ElregS/PE-1100_Elreg_Sender/Documentation/TODO.txt

1. wrong OP AMP footprint (mirror)
2. DAC D7. Remove pin 28 and use PIN 60 as D7 (do same on the other channel?)
3. Capacitor after first opamp replacet with schotky. Try again with 1uF or change schematic as terje sugested
