ElregS/PE-1100_Elreg_Sender/Documents/Trafo/Haris_uktatko_Savjeti.odt

Mislim da toridualni ferit nije dobar zato sto ima malu Effective area (ispada da se ne racuna bas kao poprjecni prjesjek). Inace bi bio dobar jer ima malo rasipanja.

Ispada da moram naci minimalni broj namotaja. Onda namotam koliko mogu na sekundar (npr .primar 5, sekundar 50), Onda iz toga vidim koliki mogu imati napon na sekundaru.

Npr. ako je primar 60Vpp, onda na sekundaru mogu dobiti 600Vpp. To znaci da je struja na 6App ako je 100 Ohma. Na primaru moram obezbjediti 60App

Ako je transducer 200 Ohma, onda moram smanjiti struju na primaaru na 30A (smanjiti DAC sinusoidu) tako da na sekundaru imam 3A, 600V, odnosno na primaru 60Vpp

Haris u Skype, kako zapoceti:

1. uzmes jezgro Koje ti odgovara po velicini

2. na osnovu osobina jezgra i volt-sekund balanca odredis koji je minimalni broj namotaja koj ti treba n=(V * deltaT)/ B*Ac (napon u jednoj poluperiodi kroz maximalnu saturaciju i poprecni presjek jezgre) tu dobijes minimalni broj namotaja koji ti trebaju da ne bi zasitio jezgru ( a sa tim minimalnim brojem namotaja dobijes i minimalnu induktivnost jer u=Ldi/dt, ako je L malo onda imas puno struje sto zasiti jezgru)

3. kada uzmes broj namotaja za primar onda odredis induktivnost L=n*n*Al (Al je uvijek zadato za svaku jezgru) i onda odmah mozes odrediti koliko ti namotaja treba na sekundaru ako znas koliki ti napon treba

4. struja na sekundaru je rezultat opterecenja sekundara, znaci zavisi samo od indukovanog napona na sekundaru i ta struja koja tece kroz Transformator nije struja magnetizacije nego je to struja opterecenja i ona moze biti mnogo veca (za idelani Transformator bi ogla biti beskonacna)

5. ako sada ne mozes uklopiti toliko broj namotaja i taj omjer koji ti treba da bi povecao struju onda se vracas na pocetak da uzmes drugu jezgru koja je veca ili smanjujes zicu koju koristis

6. ako krenes malo dublje ulaziti u strukturu transformatora mozes Naci ovakvu formulu koja kaze da zapravo pravi induktivitet magnetisanja je zapravo Lm=n1*n2/ Reluktansa, a reluktansa je Rel=duzina magnetnog puta / permeabilnost * poprecni presjek

ona zavisi samo od parametara jezgre

kada se to sve odredi onda trazis nacin kako namotati tako da imas coupling koeficijent skoro 1 (0.98 0.99 je izvodivo poprilicno lako)

Saturation is caused by excessive applied volt-seconds

The conventional transformer saturates when the applied winding voltseconds

are too large. Addition of an air gap has no effect on saturation.

Saturation can be prevented by increasing the core cross-sectional area,

or by increasing the number of primary turns.
