ElregS/PE-1100_Elreg_Sender/Documents/50_200KHz_u_vodi_dugacki_kabel.png

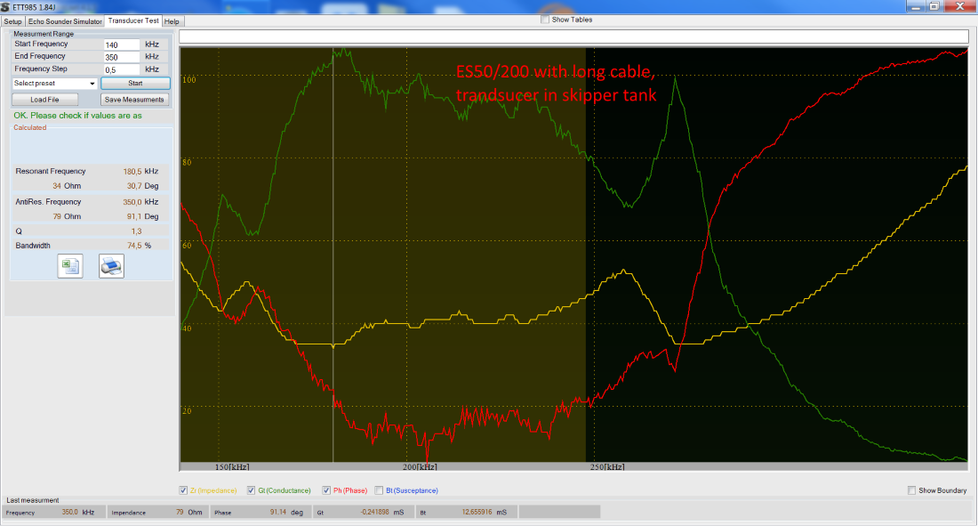
Documents/50_200KHz_u_vodi_dugacki_kabel.png
