ElregS/PE-1100_Elreg_Sender/Altium/Project Outputs for Elreg_Sender/BOM_Sender_and_Receiver.ods

Comment | Description | Designator | Quantity | Total Quantity |  | Cijena $
470pF | 470PF 50V C0G/NP0 0603 | C12, C14, C212, C214 | 4 | 100 | CL10C471JB8NNNC | 0.09 | 9
2n2 | 2200PF 50V X7R 0603 | C44, C45, C244, C245 | 4 | 100 | C0603C222K5RACTU | 0.1 | 10
10n |  | C9, C10, C209, C210 | 4 |  | not mounted, 10n? |  | 0
100nF | 100n 0603, 50V | C1, C201, C3, C5, C11, C13, C203, C205, C211, C213, C4, C6, C15, C17, C215, C217, C32, C35, C43, C40, C38 | 14 | 100 | CL10B104KB8NNNL | 0.09 | 9
1uF | 1UF 25V X5R 0603 | C2, C202 | 2 | 50 | CL10A105KA8NNNC | 0.09 | 4.5 | Mozemo sve od 1u ove vrste (25V)
1uF | 1UF 10V X5R 0603 | C16, C216 | 2 | 0 | CL10A105KP8NNNC |  | 0
3.3uF | 3.3UF 16V X6S 0603 | C7, C8 | 2 | 20 | C1608X6S1C335M080AC | 0.09 | 1.8
10uF | 10UF 10V X5R 0603 | C31, C34, C41, C42, C33, C36, C37 | 4 | 50 | GRM188R61A106KE69J | 0.19 | 9.5
10uF 35V | 10UF 35V X5R 0603 | C18, C28, C19 | 3 | 60 | GRM188R6YA106MA73D | 0.45 | 27
47uF 50V |  | C29 | 1 |  | ovaj sam pogrijesio, moramo zalemiti 10uF, 35V jer nema ovakvih 0603 |  | 0
47uF 16V |  | C30 | 1 |  | I ovaj isto |  | 0
2200u 35V | 2200UF 20% 35V RADIAL | C20, C21, C22, C23, C24, C25, C26, C27 | 8 | 20 | 35ZLH2200MEFC16X25 | 1.31 | 26.2
 |  |  |  |  |  |  | 0
Zener 12V |  | D2, D8, D202, D208 | 4 | 20 | MM3Z12VT1G | 0.15 | 3 | nije previse bitna
ES1D | DIODE GEN PURP 200V 1A SMA | D3, D4, D5, D6, D203, D204, D205, D206 | 8 | 40 | ES1D | 0.36 | 14.4
DIODE SCHOTTKY 40V 1A DO214AC |  | D9 | 1 | 10 | CDBA140-G | 0.34 | 3.4
BAV199 |  | D10, D110 | 2 | 20 | BAV99,235 | 0.13 | 2.6 | Nisam nasao BAV199, moze I ova
 |  |  |  |  |  |  | 0
SBSPP0500683MX | filter | F1 | 1 | 6 | SBSPP0500683MXT | 1.29 | 7.74
AP2210N-3.3 or MCP1811AT-012/TTCT-ND | linear reg. 3.3V 300mA | IC1, IC9 | 1 | 20 | AP2210N-3.3TRG1 | 0.42 | 8.4
AP2210N-5.0 | LINEAR 5V 300MA | IC8, IC11 | 2 | 20 | AP2210N-5.0TRG1 | 0.42 | 8.4
BD70GA5WEFJ-E2 | linear reg. 7V, 500mA | IC7 | 1 | 10 | BD70GA5WEFJ-E2 | 0.69 | 6.9
LM5002 | DC/DC | IC6 | 1 | 4 | LM5002MAX/NOPB | 3.83 | 15.32
VX78012-500 | DC DC CONVERTER 12V 6W | IC10 | 1 | 4 | VX78012-500 | 2.78 | 11.12
 |  |  |  |  |  |  | 0
AD823AARZ-ND | IC OPAMP JFET 16MHZ RRO 8-MSOP | IC2, IC202 | 2 | 8 | AD823AARZ | 7.36 | 58.88
LMV116MF | OPAMP | IC3, IC4, IC203, IC204 | 4 | 16 | LMV116MFX/NOPB | 1.6 | 25.6
TLC7528EDW | DAC | IC5, IC205 | 2 | 8 | TLC7528EDW | 5.56 | 44.48
 |  |  |  |  |  |  | 0
330UH 1.15A |  | L1 | 1 | 4 | SRR1260-331K |  | 0
1uH 0805 |  | L2, L3 | 2 | 20 | LBR2012T1R0M |  | 0
BUK7Y9R9 |  | Q1, Q2, Q201, Q202 | 4 | 16 | BUK7Y9R9 | 1.02 | 16.32
15k NM | RES xx OHM 1/8W 5% 0805 SMD | R1, R9, R201, R209 | 4 |  |  |  | 0
4k1 NM | RES xx OHM 1/8W 5% 0805 SMD | R2, R10, R202, R210 | 4 |  |  |  | 0
0R | RES xx OHM 1/8W 5% 0805 SMD | R5, R14, R214, R205 | 4 | 100 | RMCF0603ZT0R00 |  | 0
33mOhm | 33m Ohm, 7W | R7, R15, R207, R215 | 4 | 16 | WSHM2818R0330FEA | 1.26 | 20.16 | Jedan od ovih 33mOhm
50mOhm | 0.05 Ohm 10W | R7, R15, R207, R215 | 4 | 16 | WSHP2818R0500FEA | 1.46 | 23.36 | ili ovaj
100mOhm 2818 | 0.1Ohm 7W | R7, R15, R207, R215 | 4 | 16 | WSHM2818R1000FEA | 1.26 | 20.16 | ili ovaj
1R |  | R3, R11, R203, R211 | 4 | 100 | RC0603FR-071RL |  | 0 | !!! ovaj je na semi 0.5 ali sam narucio 1 Ohm
10R |  |  |  | 100 | ERJ-3EKF10R0V |  | 0
22R |  |  |  | 100 | RMCF0603FT22R0 |  | 0
100R |  |  |  | 100 | RMCF0603FT100R |  | 0
470R | RES SMD 470 OHM 1% 0.4W 0805 | R4, R12, R204, R212 | 4 | 100 | CRGCQ0603F470R |  | 0
1k |  |  |  | 100 | RMCF0603FT1K00 |  | 0
1.47k | RES xx OHM 1/8W 5% 0805 SMD | R20 | 1 | 100 | RMCF0603FT1K47 |  | 0
2K 2W |  | R21, R22, R121, R122 | 4 | 100 | RMCF2512JT2K00 |  | 0
3k3 | 3.3K OHM 1% 1/10W 0603 |  |  | 100 | RC0603FR-073K3L |  | 0
6k04 | RES 1 KOHM 1/8W 1% 0805 SMD | R18 | 1 | 100 | RMCF0603FT6K04 |  | 0
39k |  |  |  | 100 | RK73H1JTTD3902F |  | 0
47k | RES SMD 47k 1% 0.4W 0805, RES SMD 47k 1% 0.4W 0805, RES xx OHM 1/8W 5% 0805 SMD, RES SMD 47k 1% 0.4W 0805, RES SMD 47k 1% 0.4W 0805, RES xx OHM 1/8W 5% 0805 SMD | R6, R13, R23, R206, R213, R223 | 6 | 100 | RC0603FR-0747KL |  | 0
52.3k | RES xx OHM 1/8W 5% 0805 SMD | R19 | 1 | 100 | RMCF0603FT52K3 |  | 0
54.9k | RES xx OHM 1/8W 5% 0805 SMD | R16 | 1 | 100 | RK73H1JTTD5492F |  | 0
60k4 | RES 1 KOHM 1/8W 1% 0805 SMD | R24 | 1 | 100 | RMCF0603FT60K4 |  | 0
73.2k | RES xx OHM 1/8W 5% 0805 SMD | R17 | 1 | 100 | RMCF0603FT73K2 |  | 0
100k |  |  |  | 100 | RMCF0603FT100K |  | 0
 |  |  |  |  |  |  | 0
Trafo | trafo COVER PLATE |  | 2 | 2 | B66414A7000X000 | 0.63 | 1.26 | Treba ukupno 2 komada (samo da probamo)
Trafo | trafo Yoke |  | 2 | 8 | B66414B2000X000 |  | 0
Trafo | trafo Coil Forme |  | 1 | 4 | B66414B6008T001 |  | 0
Trafo | ferrite, gapped N87 |  | 2 | 6 | B66413U0160L187 |  | 0
Trafo | ferrite ungapped, N49 |  | 2 | 4 | B66413G0000X149 | 0.63 | 2.52
Trafo | ferrite ungapped, N87 |  | 2 | 4 | B66413G0000X187 | 0.49 | 1.96
 |  |  |  |  |  |  | 0
AD8656 | OP AMP |  | 1 | 6 | AD8656ARMZ-ND | 3.29 | 19.74
AQY214S | opto isol. Relay |  | 2 | 8 | AQY214S | 1.57 | 12.56
ADS1675 | ADC 24BIT SIGMA-DELTA |  | 2 | 7 | ADS1675IPAG | 36.2 | 253.4
LMP8350MA/NOPB | diff. Opamp |  | 5 | 7 | LMP8350MA/NOPB | 6.16 | 43.12
PE-68386 | trafo, receiver |  | 2 | 8 | PE-68386NL | 2.1 | 16.8
 |  |  |  |  |  |  | 0
FPGA kit koji Hadzem korsiti i nauriciti jedan za mene (i ako vama treba jos jedan?) |  |  | 1 | 1 |  |  | 0
konektor za receiver |  |  | 2 | 8 | TS-114-G-A |  | 0
 |  |  |  |  |  |  | 0
Connector header (male) za NMEA tester |  |  | 2 | 12 | 2029030-2 |  | 0
Housing Connector (female) za NEMA tester |  |  | 2 | 12 | 2029047-2 |  | 0
CONN SOCKET |  |  | 4 | 24 | 794611-1 |  | 0
CONN SOCKET |  |  | 4 | 24 | 1-794607-1 |  | 0
 |  |  |  |  |  | TOTAL | 738.6 | Ovdje nije bas sve skupa, bice malo skuplje
