ElregS/PE-1100_Elreg_Sender/Altium/Project Outputs for Elreg_Sender/BOM_Elreg_Sender_ver_1_0_2_withFPGA.ods

Comment | Description | Designator | Footprint | LibRef | Quantity | Total Quantity |  | Cijena $
470pF | 470PF 50V C0G/NP0 0603 | C12, C14, C212, C214 | C-0603 | C-0603_470p_10V | 4 | 20 | CL10C471JB8NNNC | 0.09
2n2 | 2200PF 50V X7R 0603 | C44, C45, C244, C245 | CAP-1210 | C-1210 | 4 | 30 | C0603C222K5RACTU | 0.1
100nF 0805 20V | 100n 0603, 50V | C1, C201, C3, C5, C11, C13, C203, C205, C211, C213, C4, C6, C15, C17, C215, C217, C32, C35, C43, C40, C38 | C-0603 | 0805CAPxxrrrrv | 14 | 100 | CL10B104KB8NNNL | 0.09
1uF 0805 20V | 1UF 25V X5R 0603 | C2, C202 | C-0603 | 0805CAPxxrrrrv | 2 | 50 | CL10A105KA8NNNC | 0.09 | Mozemo sve od 1u ove vrste (25V)
1uF 0805 10V | 1UF 10V X5R 0603 | C16, C216 | C-0603 | 0805CAPxxrrrrv | 2 | 0 | CL10A105KP8NNNC
3.3uF | 3.3UF 16V X6S 0603 | C7, C8 | C-0805 | C-0805_3_3uF | 2 | 20 | C1608X6S1C335M080AC | 0.09
10uF | 10UF 10V X5R 0603 | C31, C34, C41, C42, C33, C36, C37 | C-0603 | C-0805_10uF | 4 | 50 | GRM188R61A106KE69J | 0.19
10uF 35V | 10UF 35V X5R 0603 | C18, C28, C19 | C-0603 | C-0805_10uF | 3 | 40 | GRM188R6YA106MA73D | 0.45
47uF 50V |  | C29 | C-0603 | C-0805_10uF | 1 |  | ovaj sam pogrijesio, moramo staviti 10uF, 35V jer nema ovakvih 0603
47uF 16V |  | C30 | C-0603 | C-0805_3_3uF | 1 |  | I ovaj isto
2200u 35V | 2200UF 20% 35V RADIAL | C20, C21, C22, C23, C24, C25, C26, C27 | CAP_16X25 | CAP_2200uF_35V | 8 | 20 | 35ZLH2200MEFC16X25 | 1.31
C-0805 |  | C9, C10, C209, C210 | C-0805 | C-0805 | 4 |  | not mounted, 10n?
Test_Point |  | D1_1, D1_2, D2_1, D2_2, G1_1, G1_2, G2_1, G2_2, S1_1, S1_2, S2_1, S2_2, VTX_TP1, VTX_TP2 | Test_Point | Test_Point | 14 |  | ne treba
Zener 12V |  | D2, D8, D202, D208 | DFN380P520X45-2N | Zener 12V | 4 | 20 | MM3Z12VT1G | 0.15 | nije previse bitna
ES1D | DIODE GEN PURP 200V 1A SMA | D3, D4, D5, D6, D203, D204, D205, D206 | SMA | ES1x | 8 | 40 | ES1D | 0.36
DIODE SCHOTTKY 40V 1A DO214AC |  | D9 | DFN380P520X45-2N | DIODE SCHOTTKY 40V 1A DO214AC | 1 | 10 | CDBA140-G | 0.34
BAV199 |  | D10, D110 | BAV199 | BAV199 | 2 | 10 | BAV99,235 | 0.13 | Nisam nasao BAV199, moze I ova
DAC1 |  | DAC1_1 | Test_Point | Test_Point | 1
DAC2_2 |  | DAC1_2, DAC2_2 | Test_Point | Test_Point | 2
DAC2_1 |  | DAC2_1 | Test_Point | Test_Point | 1
SBSPP0500683MX | filter | F1 | Filter_SBSPP0500 | Filter_SBSPP0500683MX | 1 | 5 | SBSPP0500683MXT | 1.29
AP2210N-3.3 or MCP1811AT-012/TTCT-ND | linear reg. 3.3V 300mA | IC1, IC9 | SOT23-3 | AP2210N-3.3 | 1 | 10 | AP2210N-3.3TRG1 | 0.42
AD823AARZ-ND | IC OPAMP JFET 16MHZ RRO 8-MSOP | IC2, IC202 | SOIC-8 | AD823AARZ-ND | 2 | 8 | AD823AARZ | 7.36
LMV116MF | OPAMP | IC3, IC4, IC203, IC204 | SOT-23-5 | LMV116MF | 4 | 16 | LMV116MFX/NOPB | 1.6
TLC7528EDW | DAC | IC5, IC205 | SOIC-20 | TLC7528EDW | 2 | 8 | TLC7528EDW | 5.56
LM5002 | DC/DC | IC6 | SOIC127P600X205-8N | LM5002 | 1 | 4 | LM5002MAX/NOPB | 3.83
BD70GA5WEFJ-E2 | linear reg. 7V, 500mA | IC7 | HTSOP-J8 | BD70GA5WEFJ-E2 | 1 | 4 | BD70GA5WEFJ-E2 | 0.69
AP2210N-5.0 | LINEAR 5V 300MA | IC8, IC11 | SOT23-3 | AP2210N-5 | 2 | 8 | AP2210N-5.0TRG1 | 0.42
VX78012-500 | DC DC CONVERTER 12V 6W | IC10 | VREG | VX78012-500 | 1 | 4 | VX78012-500 | 2.78
24V IN |  | J1 | WAGO_2_pins | 2x1 connector | 1
CONN 3x1 |  | J2, J13 | WAGO-3_pins | 3x1 connector | 2
CH2 Receive |  | J3 | WAGO_2_pins | 2x1 connector | 1
CON1_b |  | J5, J6 | CONN1 _B | CON1_b | 2
Header 2X20 |  | J7, J8 | HEADER_2x20_2_54_1mm | HEADER_2x20_2.54_1 | 2
CON13 |  | J9 | CONN13 | CON13 | 1
CON14 |  | J10 | CONN13 | CON13 | 1
Header 2X5 | Conn Unshrouded Header HDR 10 POS 2.54mm Solder ST Thru-Hole | J11 | PIN-2X5-2.54-1.0 | HEADER_2x5_2.54 | 1
CH1 Receive |  | J14 | WAGO_2_pins | 2x1 connector | 1
330UH 1.15A |  | L1 | IND | FIXED IND 330UH 1.15A 580 MOHM | 1 | 4 | SRR1260-331K
1uH 0805 |  | L2, L3 | 0805 | induktor_0806 | 2
BUK7Y9R9 |  | Q1, Q2, Q201, Q202 | BUK7Y9R) | BUK7Y9R9 | 4 | 16 | BUK7Y9R9 | 1.02
15k NM | RES xx OHM 1/8W 5% 0805 SMD | R1, R9, R201, R209 | R-0603 | CRCW0805xxxxJN Default | 4
4k1 NM | RES xx OHM 1/8W 5% 0805 SMD | R2, R10, R202, R210 | R-0603 | CRCW0805xxxxJN Default | 4
0 0805 | RES xx OHM 1/8W 5% 0805 SMD | R5, R14, R214, R205 | R-0603 | CRCW0805xxxxJN Default | 4 | 100 | RMCF0603ZT0R00
33mOhm | 33m Ohm, 7W | R7, R15, R207, R215 |  |  | 4 | 12 | WSHM2818R0330FEA | 1.26 | Jedan od ovih 33mOhm
50mOhm | 0.05 Ohm 10W | R7, R15, R207, R215 |  |  | 4 | 12 | WSHP2818R0500FEA | 1.46 | ili ovaj
100mOhm 2818 | 0.1Ohm 7W | R7, R15, R207, R215 | RES2818 | CRCW0805xxxxJN Default | 4 | 12 | WSHM2818R1000FEA | 1.26 | ili ovaj
0.5R |  | R3, R11, R203, R211 | R-0603 | RES-0805 | 4 | 100 | RC0603FR-071RL | !!! ovaj je na semi 0.5 ali sam narucio 1 Ohm
470R | RES SMD 470 OHM 1% 0.4W 0805 | R4, R12, R204, R212 | R-0603 | R-0603_470R | 4 | 100 | CRGCQ0603F470R
1.47k 0805 | RES xx OHM 1/8W 5% 0805 SMD | R20 | R-0603 | CRCW0805xxxxJN Default | 1 | 100 | RMCF0603FT1K47
2K 2W |  | R21, R22, R121, R122 | RES2512 | RES SMD 75K OHM 1% 2W 2512 | 4 | 100 | RMCF2512JT2K00
6k04 | RES 1 KOHM 1/8W 1% 0805 SMD | R18 | R-0603 | CRCW08051K00FKEA | 1 | 100 | RMCF0603FT6K04
47k | RES SMD 47k 1% 0.4W 0805, RES SMD 47k 1% 0.4W 0805, RES xx OHM 1/8W 5% 0805 SMD, RES SMD 47k 1% 0.4W 0805, RES SMD 47k 1% 0.4W 0805, RES xx OHM 1/8W 5% 0805 SMD | R6, R13, R23, R206, R213, R223 | R-0603 | R-0603_47k, R-0603_47k, CRCW0805xxxxJN Default, R-0603_47k, R-0603_47k, CRCW0805xxxxJN Default | 6 | 100 | RC0603FR-0747KL
52.3k 0805 | RES xx OHM 1/8W 5% 0805 SMD | R19 | R-0603 | CRCW0805xxxxJN Default | 1 | 100 | RMCF0603FT52K3
54.9k 0805 | RES xx OHM 1/8W 5% 0805 SMD | R16 | R-0603 | CRCW0805xxxxJN Default | 1 | 100 | RK73H1JTTD5492F
60k4 | RES 1 KOHM 1/8W 1% 0805 SMD | R24 | R-0603 | CRCW08051K00FKEA | 1 | 100 | RMCF0603FT60K4
73.2k 0805 | RES xx OHM 1/8W 5% 0805 SMD | R17 | R-0603 | CRCW0805xxxxJN Default | 1 | 100 | RMCF0603FT73K2
0R NM | RES xx OHM 1/8W 5% 0805 SMD | R8, R208 | RES-0805 | CRCW0805xxxxJN Default | 2
5V FPGA |  | TP5 | Test_Point | Test_Point | 1
10:10:150 |  | TR1, TR2 | Trafo_15x15 | TRAFO_15x15 | 2
Trafo | trafo COVER PLATE |  |  |  | 2 | 2 | B66414A7000X000 | 0.63 | Treba ukupno 2 komada (samo da probamo)
Trafo | trafo Yoke |  |  |  | 2 | 8 | B66414B2000X000
Trafo | trafo Coil Forme |  |  |  | 1 | 4 | B66414B6008T001
Trafo | ferrite, gapped N87 |  |  |  | 2 | 6 | B66413U0160L187
Trafo | ferrite ungapped, N49 |  |  |  | 2 | 4 | B66413G0000X149 | 0.63
Trafo | ferrite ungapped, N87 |  |  |  | 2 | 4 | B66413G0000X187 | 0.49
