ElregS/PE-1100_Elreg_Sender/Altium/Project Outputs for Elreg_Sender/Bill_of_Materilas_Elreg_Sender_Ver_1_0_1.xls

Comment | Description | Designator | Footprint |  | Quantity |  | Ukupno
3300pF 500V |  | C3, C4 | CAP1206 | C0805C332K5RACTU | 2 | 0.11 | 0.22
2200pF 0805 35V | CAP CER rrrrUF xV x% type 0805 | C5 | CAP-0805 | C0805C222K5RACTU | 1 | 0.1 | 0.1
4.7uF 0805 35V | CAP CER rrrrUF xV x% type 0805 | C6 | CAP-0805 | CL21A475KLCLQNC | 1 | 0.24 | 0.24
1uF 0805 35V | CAP CER rrrrUF xV x% type 0805 | C8 | CAP-0805 | CL21B105KLFVPNE | 1 | 0.27 | 0.27
10uF 0805 35V | CAP CER rrrrUF xV x% type 0805 | C9, C10, C11, C12, C16, C17 | CAP-0805 | GMK212BBJ106MG-T | 6 | 0.75 | 4.5
0.1uF 0805 50V | CAP CER rrrrUF xV x% type 0805 | C13, C14, C26, C28, C15 | C-0805 | CL21B104MBCNNNC | 5 | 0.1 | 0.5
CAP_EL_4700uF/35V |  | C22, C23 | CAP_TR_18mmx40mm | UPW1V472MHD | 2 | 3.2 | 6.4
NM |  | C25 | C-0805 |  | 1 |  | 0
10uF 0805 5V | CAP CER rrrrUF xV x% type 0805 | C27, C29 | C-0805 | LMK212B7106KG-TD | 2 |  | 0
CMF04(TE12LQM)CT-ND |  | D1, D2 | DFN380P470X45-2N | CMF04(TE12L,Q,M) | 2 | 0.45 | 0.9
DIODE SCHOTTKY 40V 1A DO214AC |  | D3 | DFN380P520X45-2N | CDBA140-G | 1 | 0.37 | 0.37
SMAJ5.0CA |  | D4 | DFN440P429X229-2N | SMAJ5.0CA-13-F | 1 | 0.46 | 0.46
BAV199 |  | D5 | BAV199 | BAV199LT1G | 1 | 0.22 | 0.22
AD5450YUJZ | IC DAC 8BIT MULT 50MHZ TSOT23-8 | IC1, IC3 | TSOP65P280X110-8N | AD5452YUJZ-REEL7CT-ND | 2 | 6.5 | 13
AD823AARZ-ND | IC OPAMP JFET 16MHZ RRO 8-MSOP | IC2 | SOIC-8 | AD823AARZ-ND | 1 | 8.05 | 8.05
LM5002 | IC REG | IC4 | SOIC127P600X205-8N | LM5002MAX/NOPB | 1 | 3.83 | 3.83
R-78E3.3-0.5 | 3V3 | IC5 | VREG | R-78E3.3-0.5 | 1 | 2.7 | 2.7
R-7812-0.5 | 12V | IC6 | VREG | R-7812-0.5 | 1 | 7.49 | 7.49
R-786.5-0.5 | 6.5V | IC7 | VREG | R-786.5-0.5 | 1 | 7.49 | 7.49
CTB0102/2 |  | J1, J2 | TBLOCK |  | 2 |  | 0
CONN 10x1 |  | J3 | CONN 10x1 |  | 1 |  | 0
CONN 2x1 |  | J4 | CONN 2x1 |  | 1 |  | 0
330UH 1.15A |  | L1 | IND | SRR1260-331K | 1 | 1.27 | 1.27
IRFB4410Z | MOSFET N-CH 100V 97A TO-220AB | Q1, Q2 | IRFB | IRFB4410ZPBF-ND | 2 | 1.91 | 3.82
0 0805 | RES xx OHM 1/8W 5% 0805 SMD | R1, R2 | RES-0805 |  | 2 |  | 0
0.1 2812 | 0.1Ohm 10W | R5, R6 | RES2818 | WSHP2818R1000FEA | 2 | 1.63 | 3.26
75K 2W |  | R7, R8 | RES2512 |  | 2 |  | 0
1k 0805 1% | RES 1 KOHM 1/8W 1% 0805 SMD | R9 | RES-0805 |  | 1 |  | 0
54.9k 0805 | RES xx OHM 1/8W 5% 0805 SMD | R10 | RES-0805 |  | 1 |  | 0
73.2k 0805 | RES xx OHM 1/8W 5% 0805 SMD | R11 | RES-0805 |  | 1 |  | 0
52.3k 0805 | RES xx OHM 1/8W 5% 0805 SMD | R13 | RES-0805 |  | 1 |  | 0
1.47k 0805 | RES xx OHM 1/8W 5% 0805 SMD | R14 | RES-0805 |  | 1 |  | 0
2K 2W |  | R20, R21 | RES2512 |  | 2 |  | 0
TR N:M |  | TR1 | EL_TRAFO2 | B65811J0000R087 | 1 | 2.26 | 2.26
 |  |  | KUCISTE | B65812N1005D001 | 1 | 1.58 | 1.58
 |  |  | CLAMP | B65812A2203X000 | 2 | 0.34 | 0.68
 |  |  |  |  |  |  | 69.61
