ElregS/PE-1100_Elreg_Sender/Altium/Project Outputs for Elreg_Sender/PDF Files/ShematicPrints_Elreg_Sender.PDF

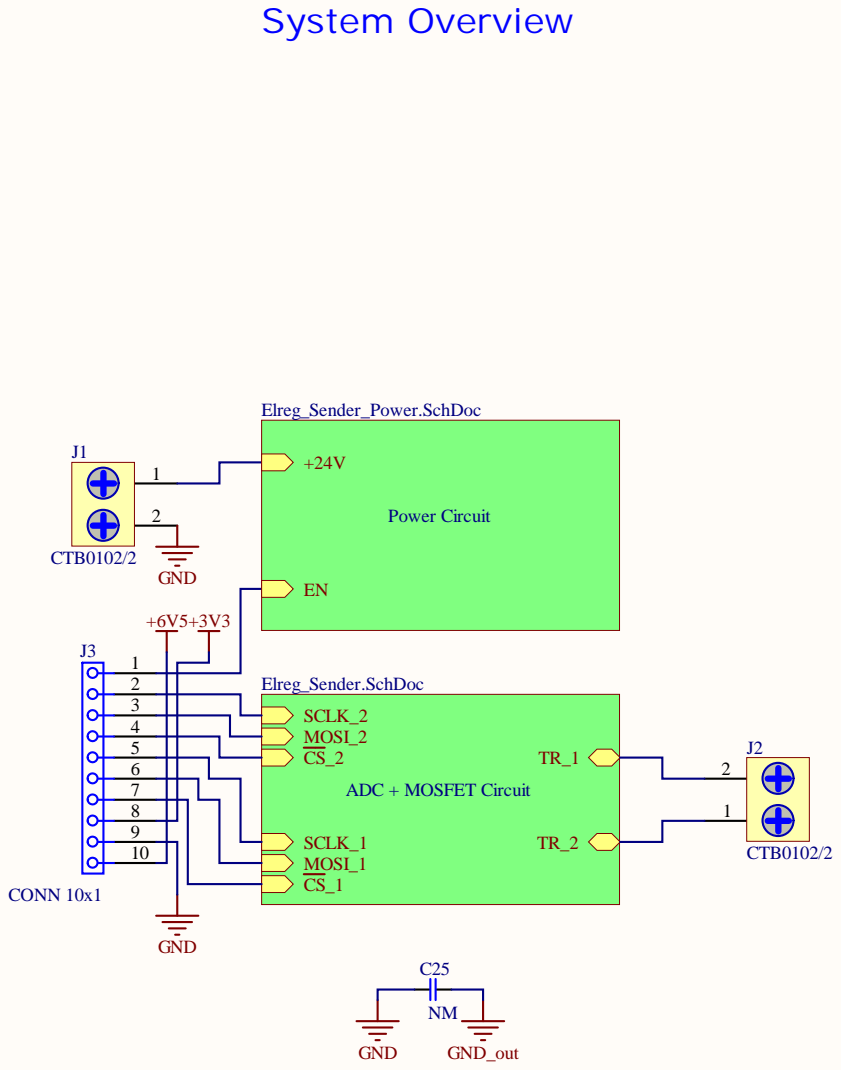
[picture p3: page 1]

3 | SCLK_2 MOSI_2 CS_2 TR_1 ADC + MOSFET Circuit SCLK_1 TR_2 MOSI_1 CS_1

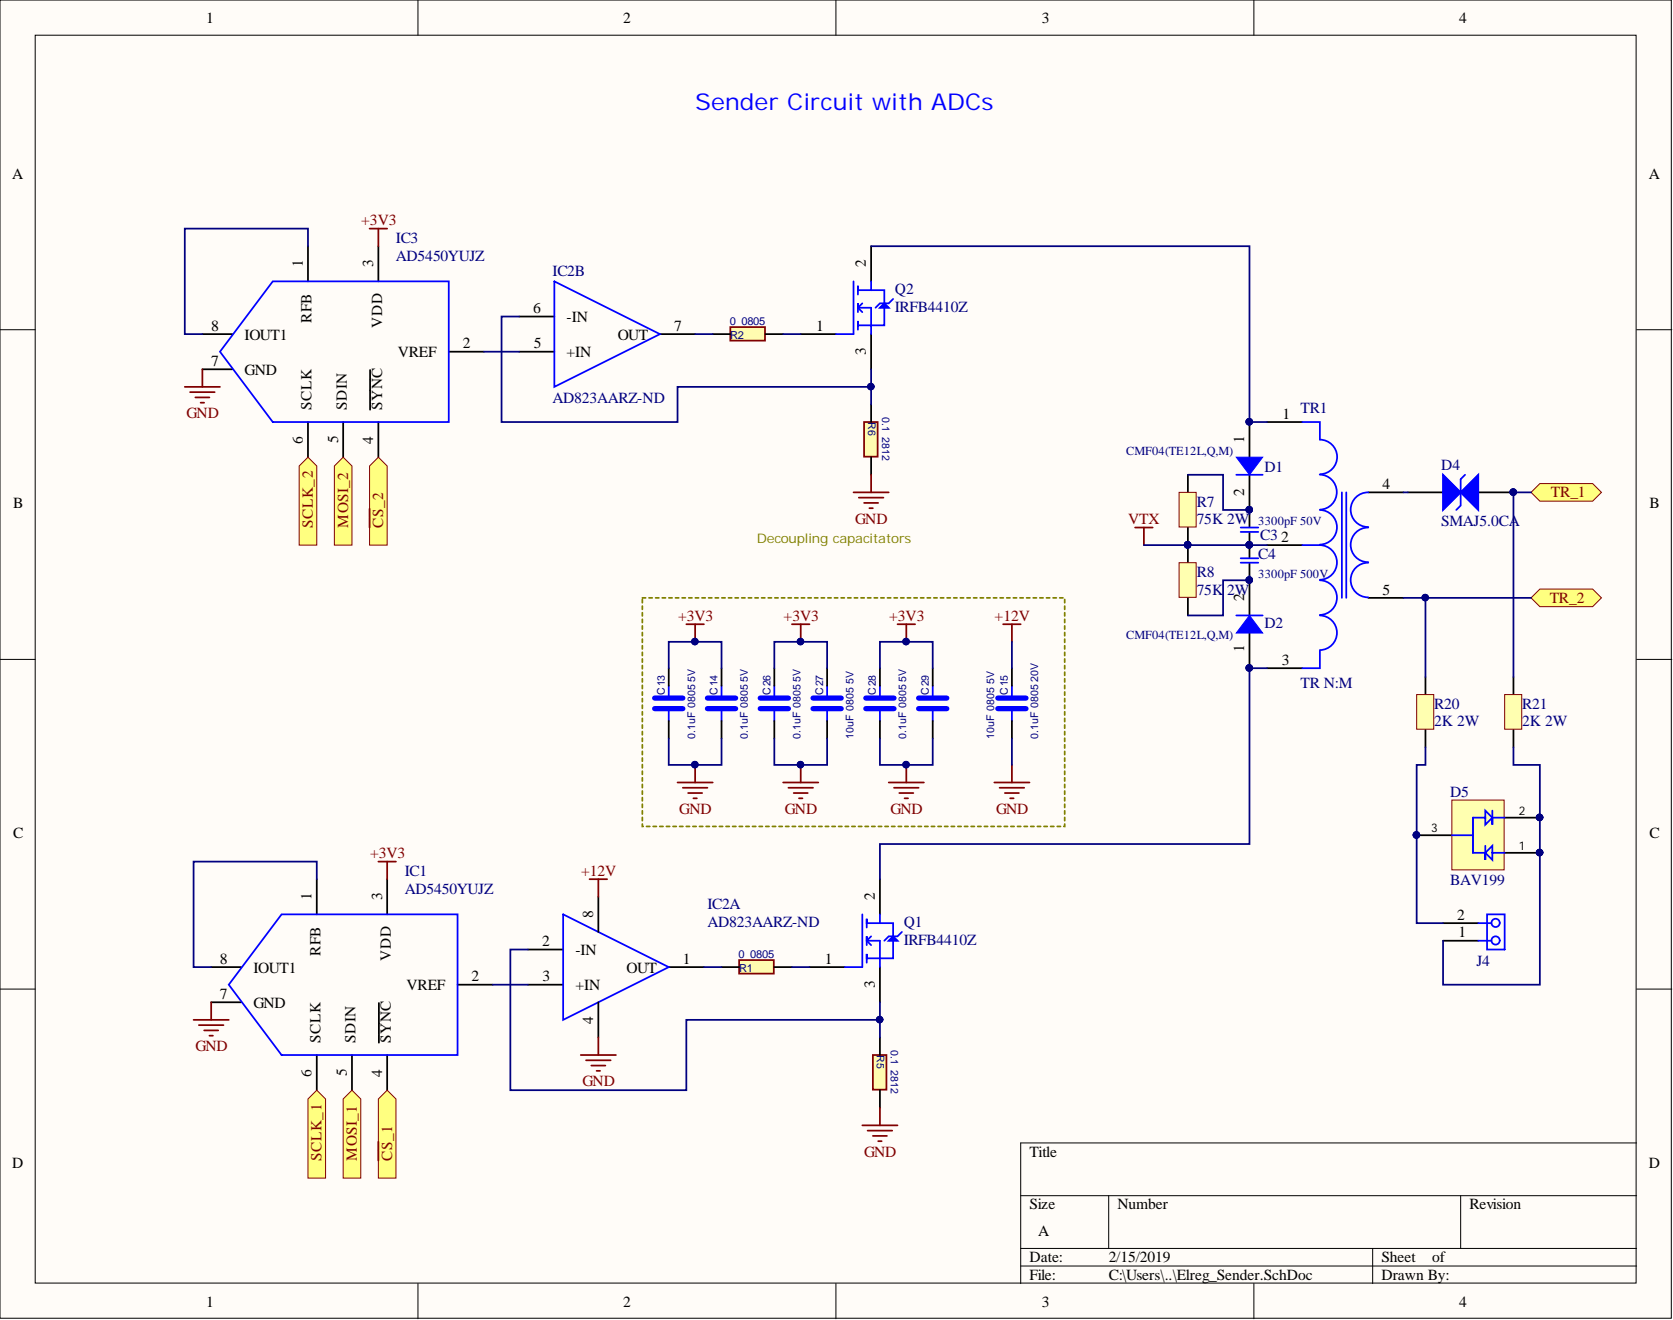
[picture p4: page 2]

GND

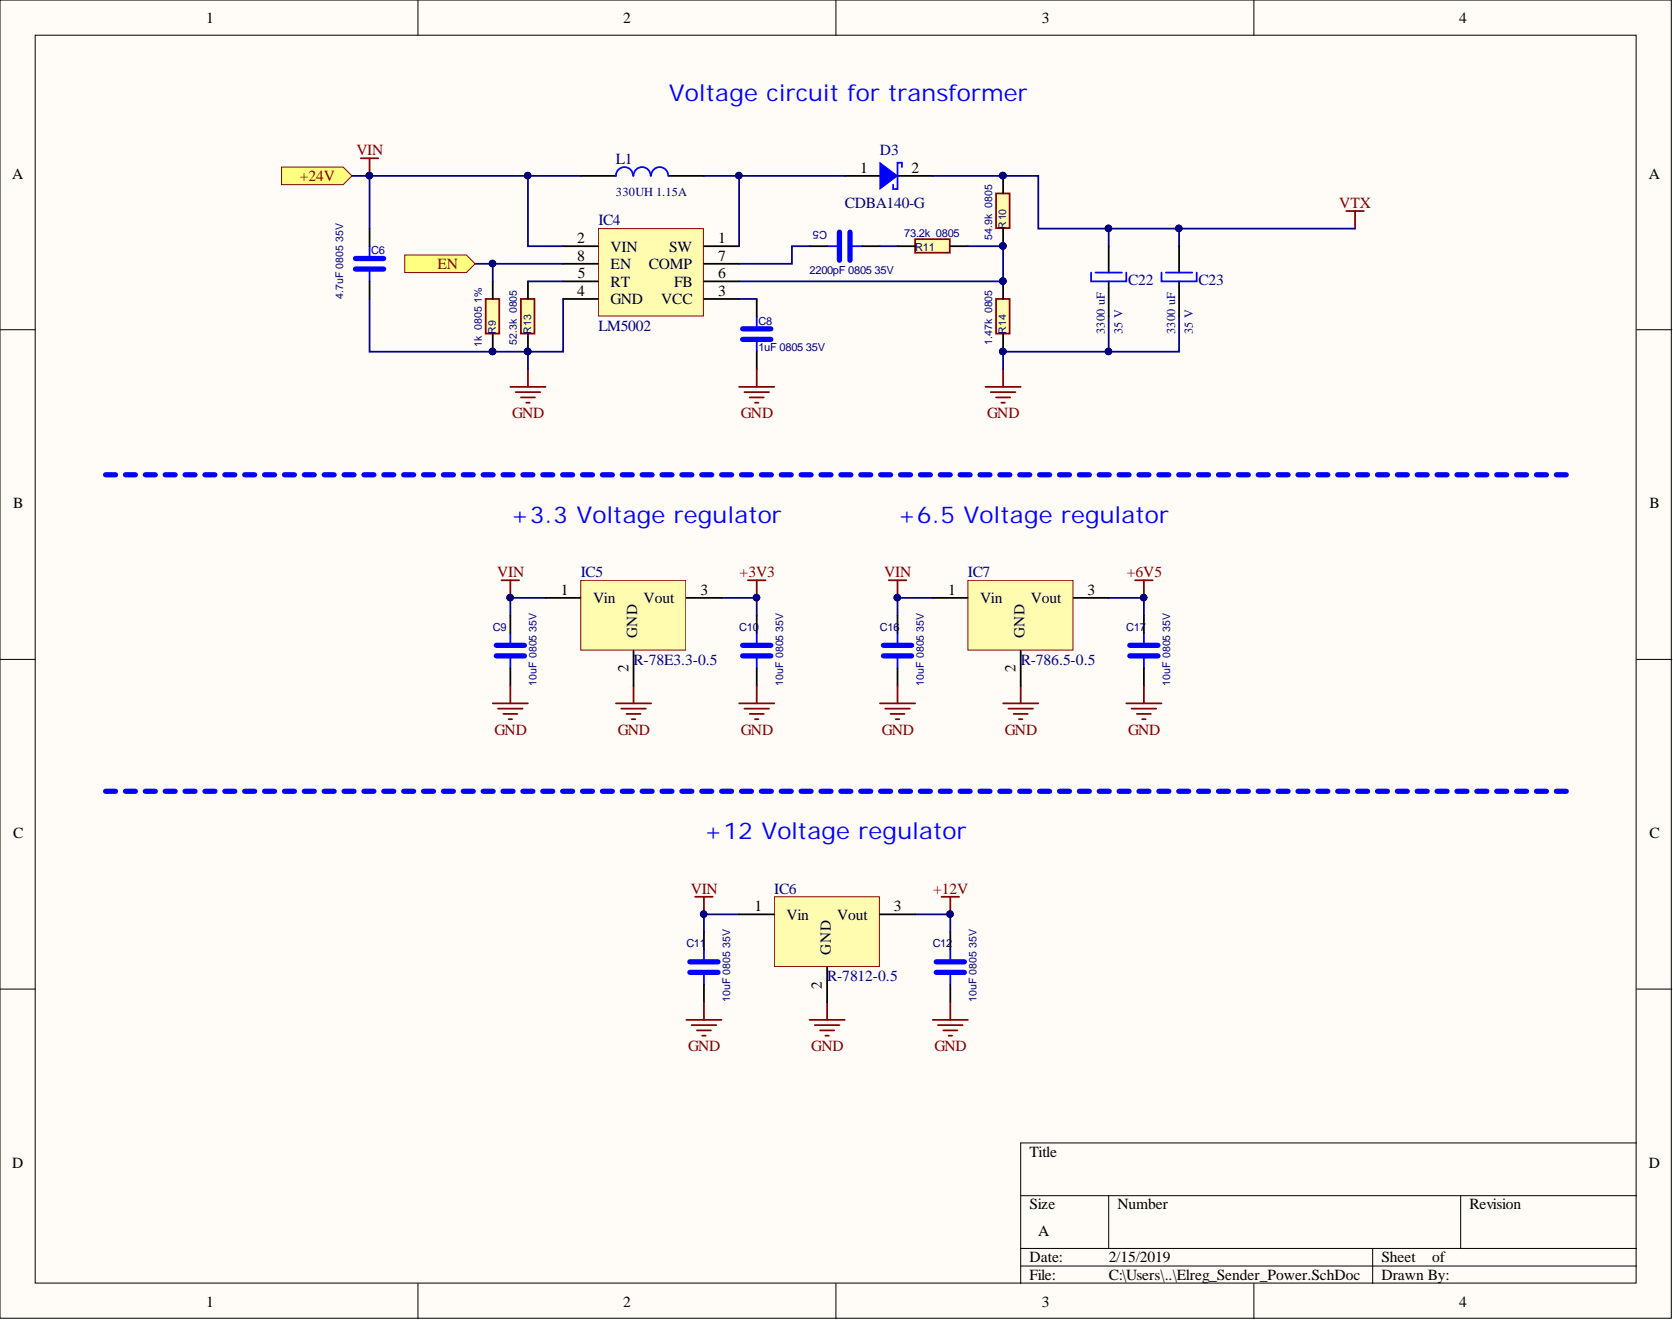
[picture p5: page 3]

Voltage circuit for transformer
