ElregS/PE-1100_Elreg_Sender/Simulation/DAC_pulsSimulate.asc

C1: cap; 10n
R1: res; 1000
V1: voltage; PWL REPEAT FOR 50 (file=200k_DAC_signal.txt) ENDREPEAT
Named nets: 0, g
.tran 0.001
