ElregS/PE-1100_Elreg_Sender/(list of files, drawings)

Other design files:
Altium/Elreg_Sender.PcbDoc
Altium/Elreg_Sender.PcbLib
Altium/Elreg_Sender.PrjPCB
Altium/Elreg_Sender.SchDoc
Altium/Elreg_Sender.SchLib
Altium/Elreg_Sender_CH2.SchDoc
Altium/Elreg_Sender_Power.SchDoc
Altium/Elreg_Sender_Top.SchDoc
Simulation/Sender.ms12
