ElregS/PE-1100_Elreg_Sender/Documentation/ImpedanceTest_transducerFor_DL1_DL2_ESN.docx

Test 200kHz transducer (from ESN50-200)

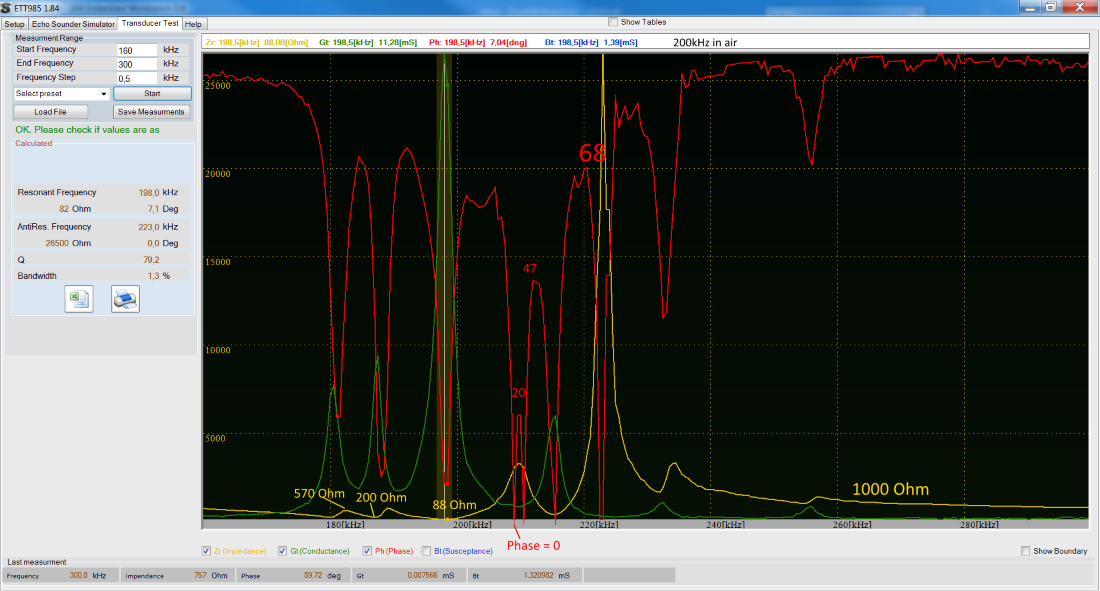
[picture p6: figure]
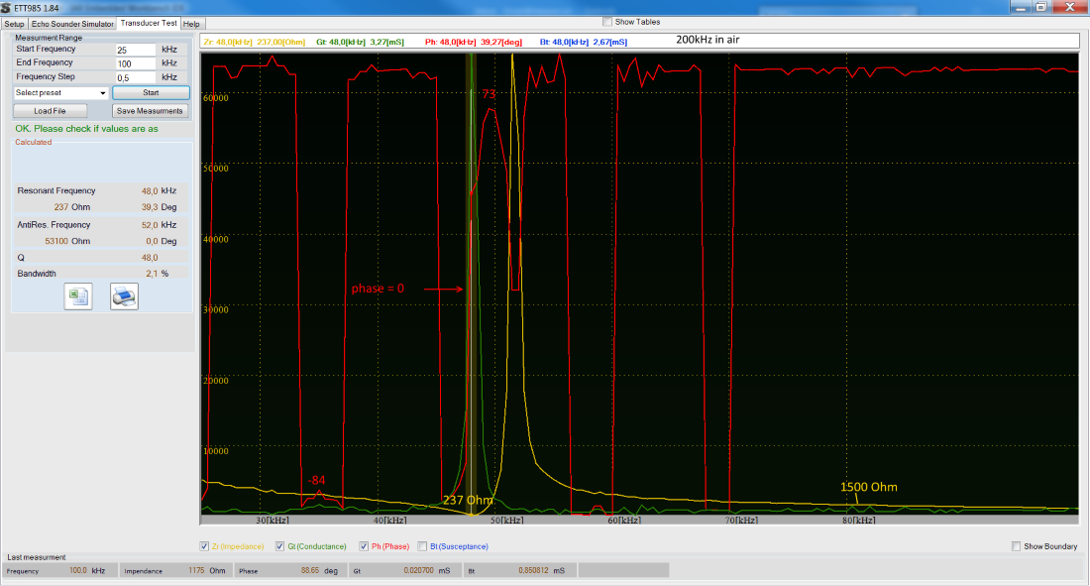
[picture p7: figure]

Test DL2 transd. (270/900kHz)

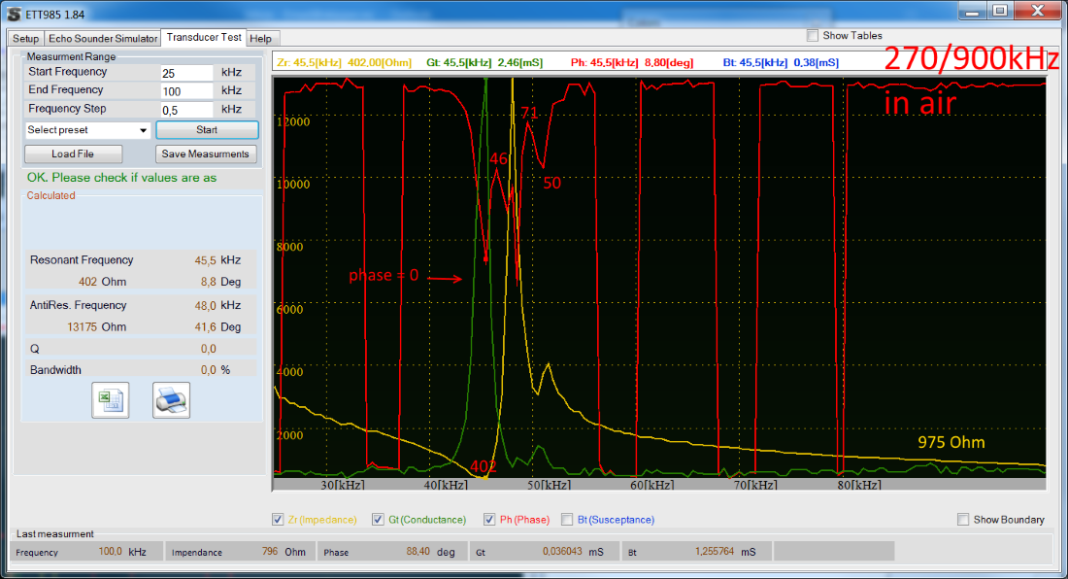
[picture p8: figure]
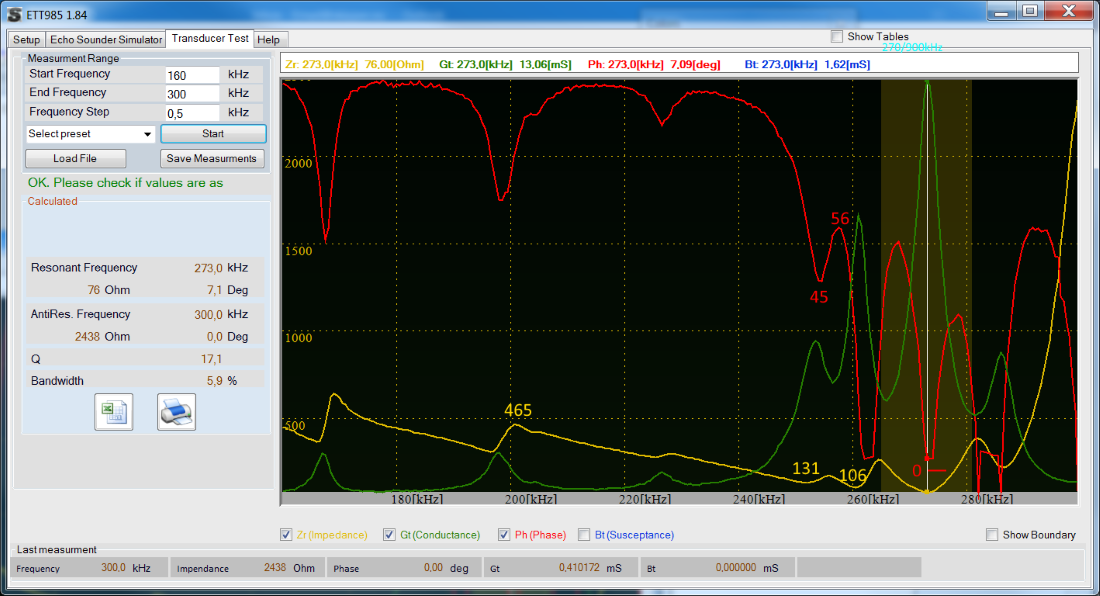
[picture p9: figure]
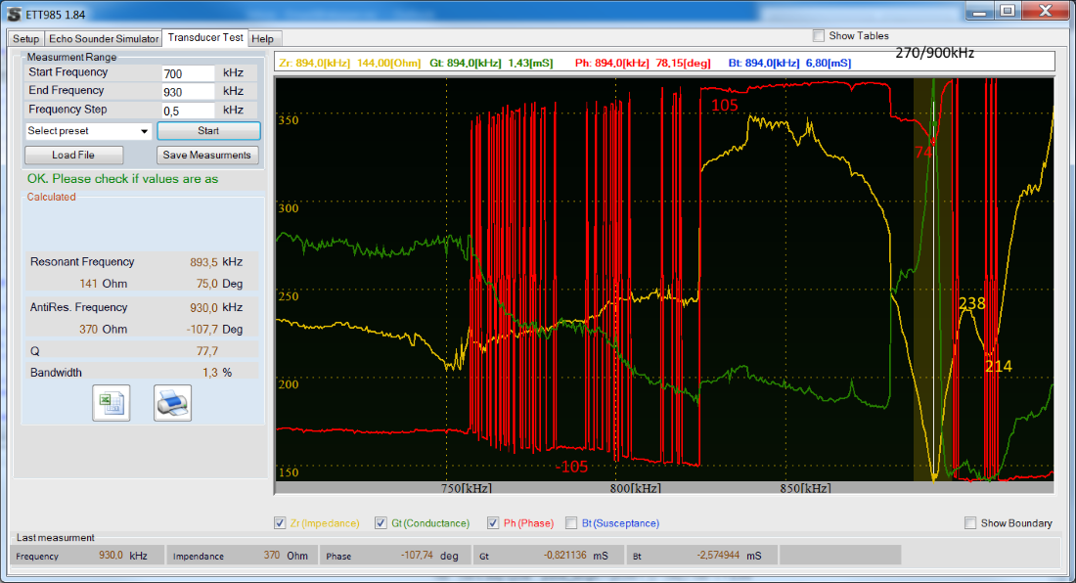
[picture p10: figure]

DL1 transducer (700kHz)

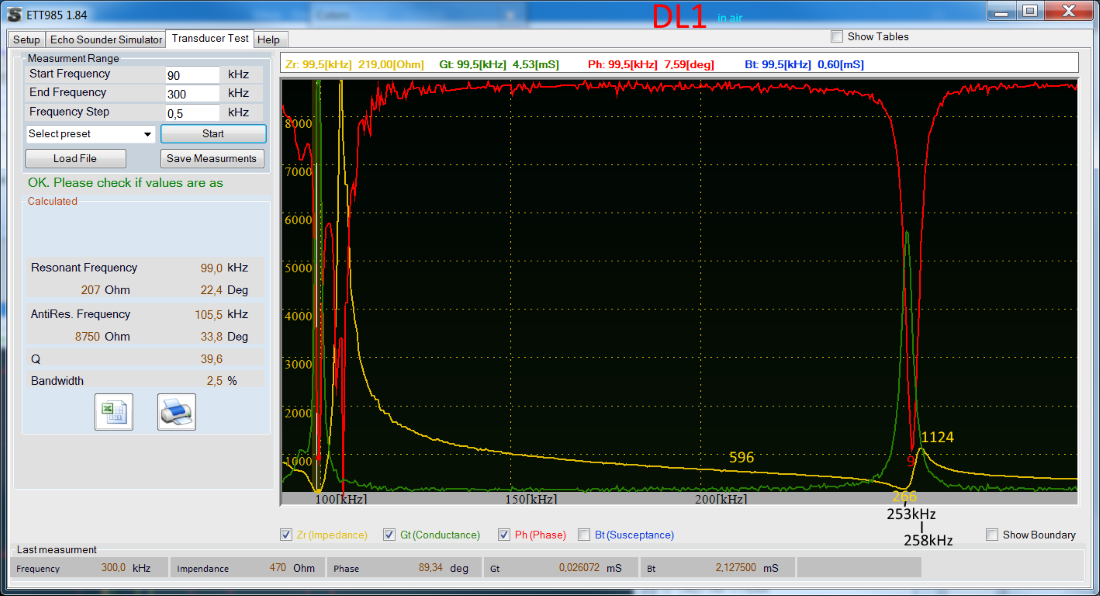
[picture p11: figure]
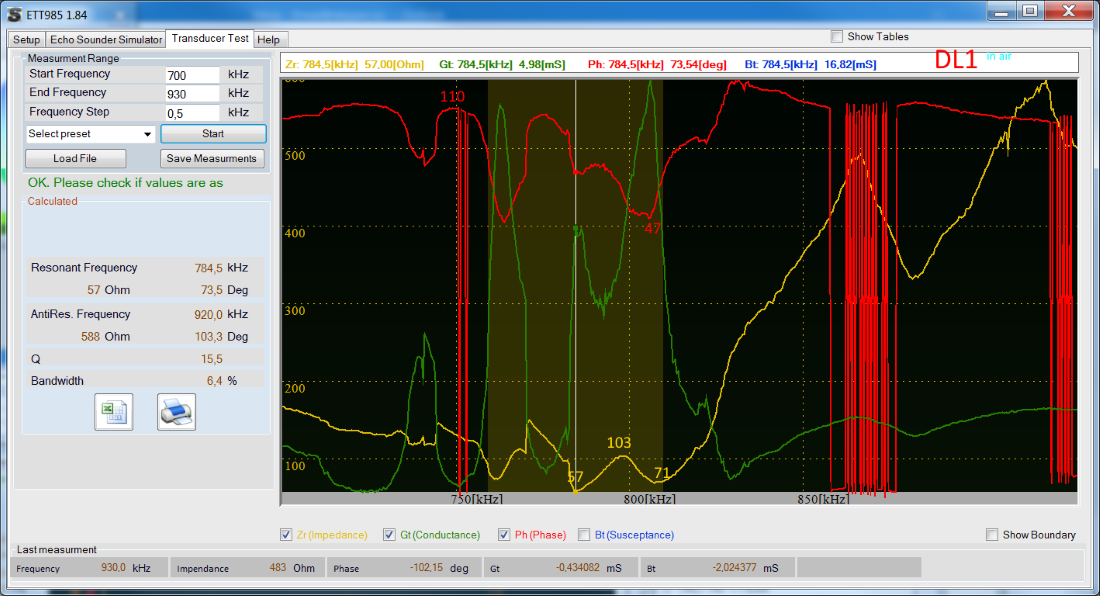
[picture p12: figure]
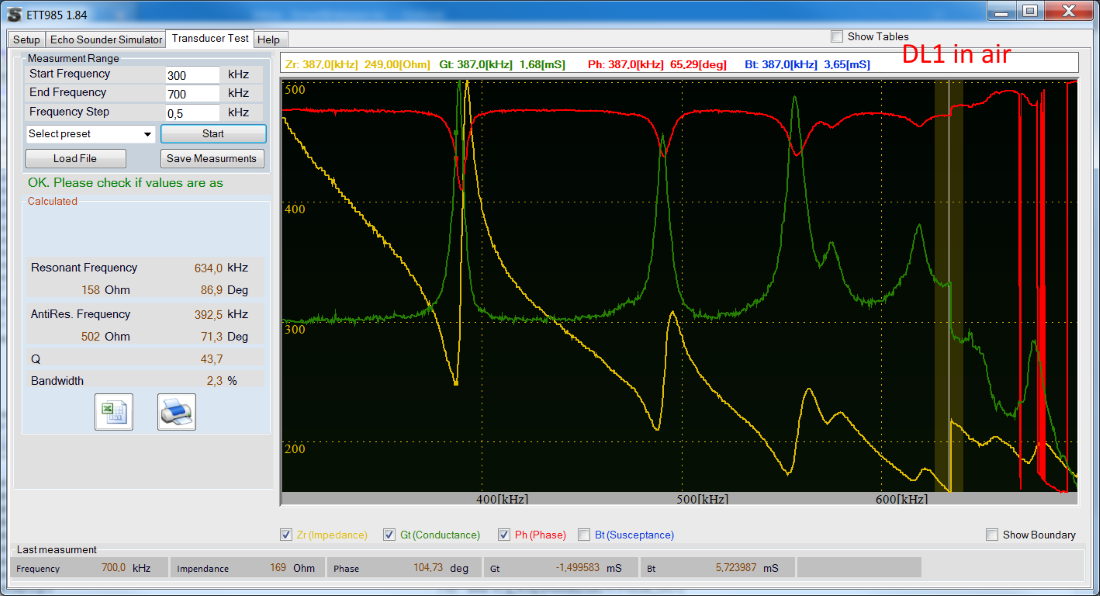
[picture p13: figure]
