ElregS/PE-1100_Elreg_Sender/(commit log)

2018-12-30 first commit, version with DAC
    [DijeloviSender.xls, Elreg_Sender.PcbDoc, Elreg_Sender.PcbLib, Elreg_Sender.PrjPCB, Elreg_Sender.SchDoc, Elreg_Sender.SchLib, Elreg_Sender_Power.SchDoc, Elreg_Sender_Top.SchDoc]
2018-12-30 Added simulation
    [Sender.ms12]
2019-01-02 added 4 decoupling
    [Elreg_Sender.PcbDoc, Elreg_Sender.PcbLib, Elreg_Sender.SchDoc, Elreg_Sender.SchLib]
2019-01-06 Removed chassis polygon on bottom layer around signals to receiver (to remove leak current/resistance to chassis?)
    [Elreg_Sender.PcbDoc]
2019-01-10 Rev. 1.0.1
    [Bill_of_Materilas_Elreg_Sender_Ver_1_0_1.xls, DijeloviSender.xls, Elreg_Sender.PcbDoc, Elreg_Sender.PrjPCB, Elreg_Sender.SchDoc, Elreg_Sender_Top.SchDoc]
2019-01-12 Output Job file
    [Elreg_Sender.PcbDoc, Elreg_Sender.SchDoc, Elreg_Sender_Power.SchDoc, Elreg_Sender_Top.SchDoc]
2019-01-12 Production files added
    [Elreg_Sender.GBL, Elreg_Sender.GBO, Elreg_Sender.GBP, Elreg_Sender.GBS, Elreg_Sender.GKO, Elreg_Sender.GTL, Elreg_Sender.GTO, Elreg_Sender.GTP]
2019-02-15 small changes
    [Elreg_Sender.SchDoc, Elreg_Sender_Top.SchDoc]
2019-04-04 Poredjenje 2 DAC-a (zasto se grije mos fet) dokument
2019-04-10 correct DAC speed started changes for new PCB
    [Elreg_Sender.PrjPCB, Elreg_Sender.SchDoc, Elreg_Sender.SchLib]
2019-04-12 trafo doc.
    [Izracunavanje_za_TRAFO.ods, RacunanjeKalkulator.ods]
2019-08-05 Added sender CH2
    [Elreg_Sender_CH2.SchDoc]
2019-09-17 dodani konektori u bom
    [BOM_Sender_and_Receiver.ods]
2020-04-02 solid state relay (za kratko spajanje u oba smijera)
2020-08-06 mjerenje trafoa dokument
    [MjenjeTrafoa.xlsx]
